FTC-Iowa/WiFiRemote-HW/prj/WifiRemote.pdf

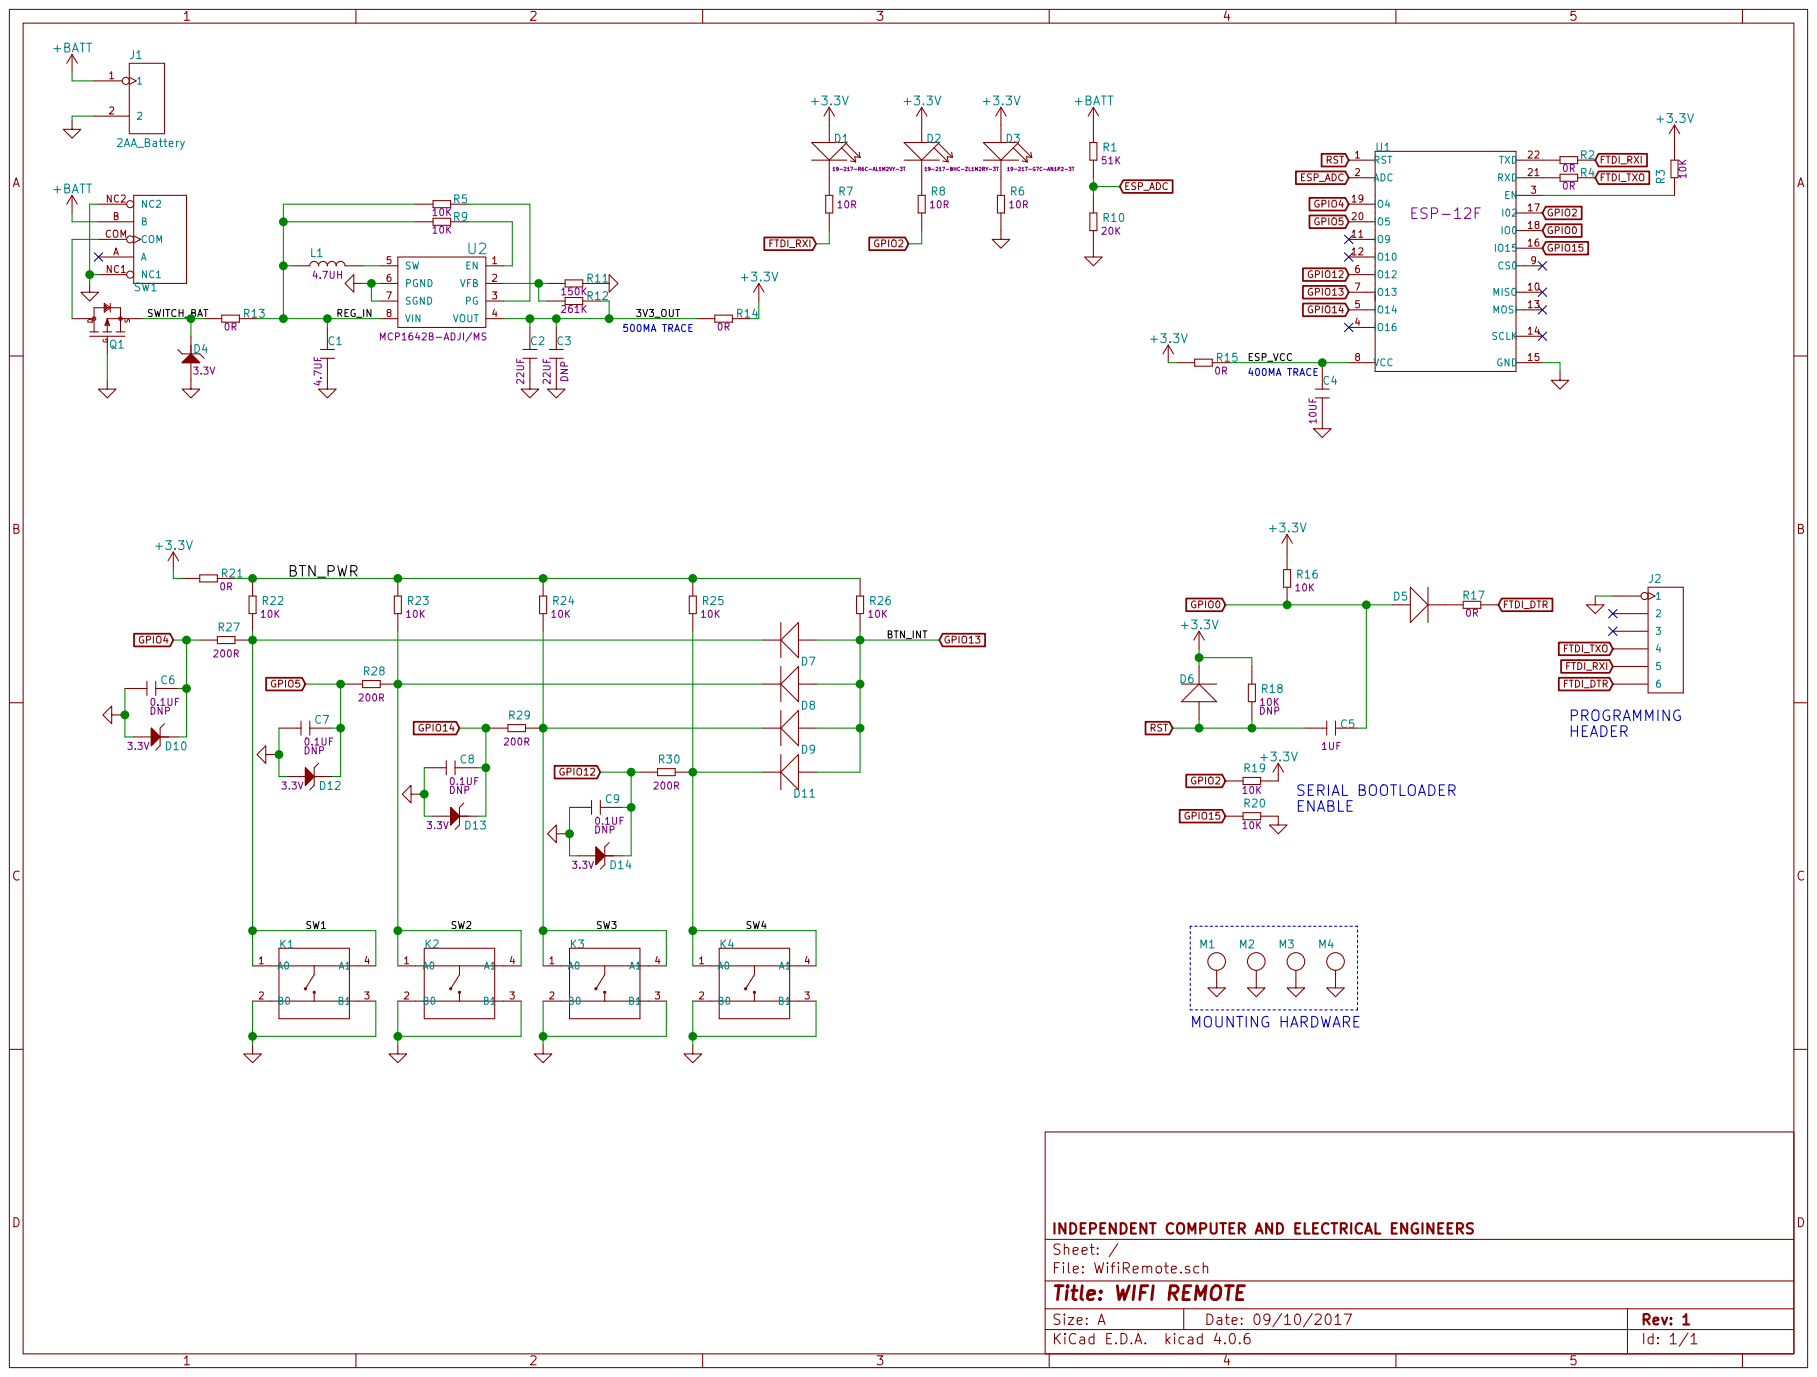
[picture p1: page 1]

B | NC1 NC1 NC2 NC2 COM COM

INDEPENDENT COMPUTER AND ELECTRICAL ENGINEERS
File: WifiRemote.sch Sheet: /
Id: 1/1 Title: WIFI REMOTE
