FTC-Iowa/WiFiRemote-HW/prj/WifiRemote.kicad_pcb

## KiCad design prj/WifiRemote.kicad_pcb (2017-12-10)

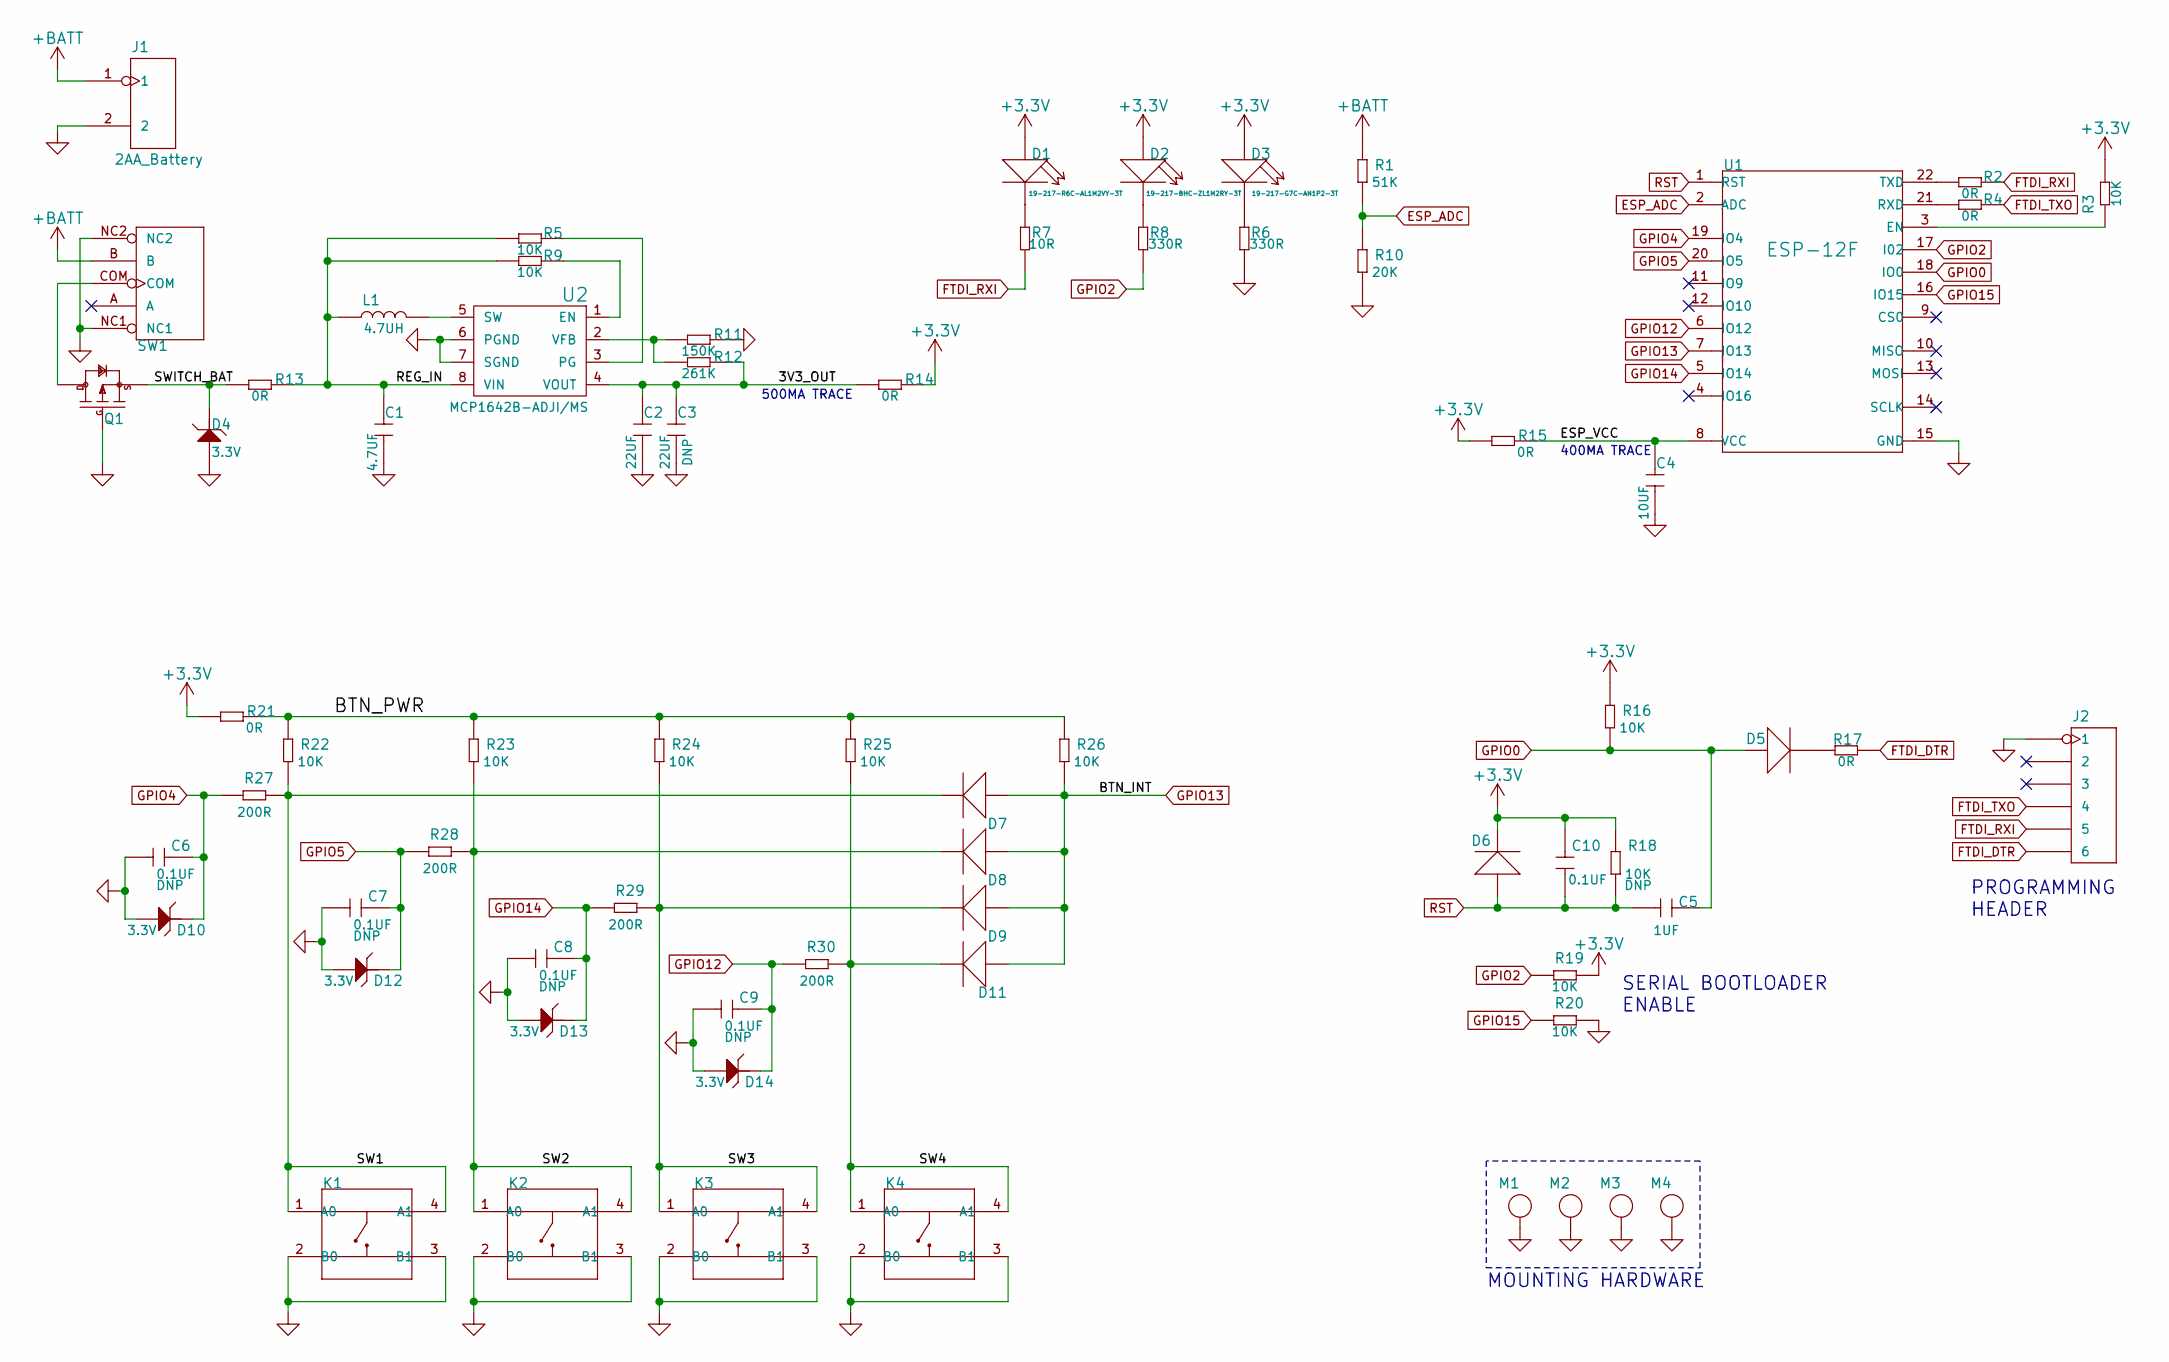
[picture p2: schematic WifiRemote.sch, WIFI REMOTE]

Parts:
C1: CERAMIC-4.7UF-10V-10%-X5R_0603_; C0603; MPN CC0603KRX5R6BB475
C2, C3: CERAMIC-22UF-6.3V-20%-X5R_0805_; C0805; MPN CC0805MKX5R5BB226
C4: CERAMIC-10UF-10V-10%-X5R_0603_; C0603; MPN CC0603KRX5R6BB106
C5: CERAMIC-1UF-25V-10%-X7R_0603_; C0603; MPN CC0603KRX7R8BB105
C6, C7, C8, C9, C10: CERAMIC-100NF-50V-10%-X7R_0603_; C0603; MPN CC0603KRX7R9BB104
D1: LED-SMD-RED-DIFFUSED_0603_; LED-0603; MPN 19-217-R6C-AL1M2VY-3T
D2: SMD-LED-CLEAR-BLUE_0603_; LED-0603; MPN 19-217-BHC-ZL1M2RY-3T
D3: SMD-LED-CLEAR-GREEN_0603_; LED-0603; MPN 19-217-G7C-AN1P2-3T
D4, D10, D12, D13, D14: SMD-Diode-TVS-3.3VMW-15V-SOD-523; SOD-523_IMPROVED; MPN CJ;CESD3V3D5
D5, D6, D7, D8, D9, D11: SMD-DIODE-SCHOTTKY-20V-1A_SOD-123_; SOD-123; MPN B5819W
J1: 2AA_Battery; header_1x2; MPN BH-321-1A
J2: DIP-BLACK-MALE-HEADER_6P-2.54_; H6-2.54; MPN P125-1106A1BS116A1
K1, K2, K3, K4: DIP-SWITCH-TACTILE-SPST-NO_TS-1109_4P-D6.0MM_; SW4-6.0X6.0X5.0MM
L1: SMD-Inductor-4.7uH-20%-L0420; ICEE_Inductor_SPD3D16-4R7M; MPN SPD3D16-4R7M
M1, M2, M3, M4: Mechanical_Mount; mounting_panhead6_5mm
Q1: SMD-MOSFET-P-CH-20V-2A-FDN340P_SOT-23_; SOT-23; MPN FDN340P
R1: SMD-RES-51K-5%-1_10W_0603_; R0603; MPN RC0603JR-0751KL
R2, R4, R13, R14, R15, R17, R21: SMD-RES-0R-5%-1_10W_0603_; R0603; MPN RC0603JR-070RL
R3, R16, R18, R19, R20, R22, R23, R24, R25, R26: SMD-RES-10K-5%-1_10W_0603_; R0603; MPN RC0603JR-0710KL
R5, R9: SMD-RES-10K-1%-1_10W_0603_; R0603; MPN RC0603FR-0710KL
R6, R8: SMD-RES-330R-1%-1_10W_0603_; R0603; MPN RC0603FR-07330RL
R7: SMD-RES-10R-5%-1_10W_0603_; R0603; MPN RC0603JR-0710RL
R10: SMD-RES-20K-1%-1_10W_0603_; R0603; MPN RC0603FR-0720KL
R11: SMD-RES-150K-1%-1_10W_0603_; R0603; MPN RC0603FR-07150KL
R12: SMD-RES-261K-1%-1_10W_0603_; R0603; MPN CRCW0603261KFKEA
R27, R28, R29, R30: SMD-RES-200R-5%-1_10W_0603_; R0603; MPN RC0603JR-07200RL
SW1: DIP-TOGGLE-SWITCH-ON-ON_3+2P-8.8X4.6MM_-90D; SW5-2.0-8.8X4.4X4.7MM-90D; MPN 3P-2.0-90D3P-2.0-90D-REINFORCE
U1: CONTROLLER-ESP8266; ESP-12F_SMT_22PIN; PART NUMBER ESP-12F
U2: BOOST-MCP1642B-ADJI/MC-MSOP8; MSOP-8_3x3mm_Pitch0.65mm; PART NUMBER MCP1642B-ADJI/MS

Connections:
+3V3: C10.1, D1.+, D2.+, D3.+, D6.-, R3.1, R14.1, R15.2, R16.1, R18.1, R19.2, R21.2
+BATT: J1.1, R1.1, SW1.B
/3V3_OUT: C2.1, C3.1, R12.1, R14.2, U2.4 (VOUT)
/BTN_PWR: R21.1, R22.1, R23.1, R24.1, R25.1, R26.1
/ESP_VCC: C4.1, R15.1, U1.8 (VCC)
/REG_IN: C1.1, L1.1, R5.2, R9.2, R13.1, U2.8 (VIN)
/SW1: D7.-, K1.1 (A0), K1.4 (A1), R22.2, R27.2
/SW2: D8.-, K2.1 (A0), K2.4 (A1), R23.2, R28.2
/SW3: D9.-, K3.1 (A0), K3.4 (A1), R24.2, R29.2
/SW4: D11.-, K4.1 (A0), K4.4 (A1), R25.2, R30.2
/SWITCH_BAT: D4.1, Q1.2 (S), R13.2
ESP_ADC: R1.2, R10.1, U1.2 (ADC)
FTDI_DTR: J2.6, R17.1
FTDI_RXI: J2.5, R2.1, R7.2
FTDI_TXO: J2.4, R4.1
GNDD: C1.2, C2.2, C3.2, C4.2, C6.1, C7.1, C8.1, C9.1, D4.2, D10.2, D12.2, D13.2, D14.2, J1.2, J2.1, K1.2 (B0), K1.3 (B1), K2.2 (B0), K2.3 (B1), K3.2 (B0), K3.3 (B1), K4.2 (B0), K4.3 (B1), M1.1, M2.1, M3.1, M4.1, Q1.1 (G), R6.2, R10.2, R11.1, R20.2, SW1.NC1, SW1.NC2, U1.15 (GND), U2.6 (PGND), U2.7 (SGND)
GPIO0: C5.2, D5.+, R16.2, U1.18 (IO0)
GPIO2: R8.2, R19.1, U1.17 (I02)
GPIO4: C6.2, D10.1, R27.1, U1.19 (IO4)
GPIO5: C7.2, D12.1, R28.1, U1.20 (IO5)
GPIO12: C9.2, D14.1, R30.1, U1.6 (IO12)
GPIO13: D7.+, D8.+, D9.+, D11.+, R26.2, U1.7 (IO13)
GPIO14: C8.2, D13.1, R29.1, U1.5 (IO14)
GPIO15: R20.1, U1.16 (IO15)
unnamed: D1.-, R7.1
unnamed: D2.-, R8.1
unnamed: D3.-, R6.1
unnamed: D5.-, R17.2
unnamed: L1.2, U2.5 (SW)
unnamed: Q1.3 (D), SW1.COM
unnamed: R2.2, U1.22 (TXD)
unnamed: R3.2, U1.3 (EN)
unnamed: R4.2, U1.21 (RXD)
unnamed: R5.1, U2.3 (PG)
unnamed: R9.1, U2.1 (EN)
unnamed: R11.2, R12.2, U2.2 (VFB)
RST: C5.1, C10.2, D6.+, R18.2, U1.1 (RST)

Notes on the sheet:
PROGRAMMING HEADER
SERIAL BOOTLOADER ENABLE
500MA TRACE
400MA TRACE
MOUNTING HARDWARE

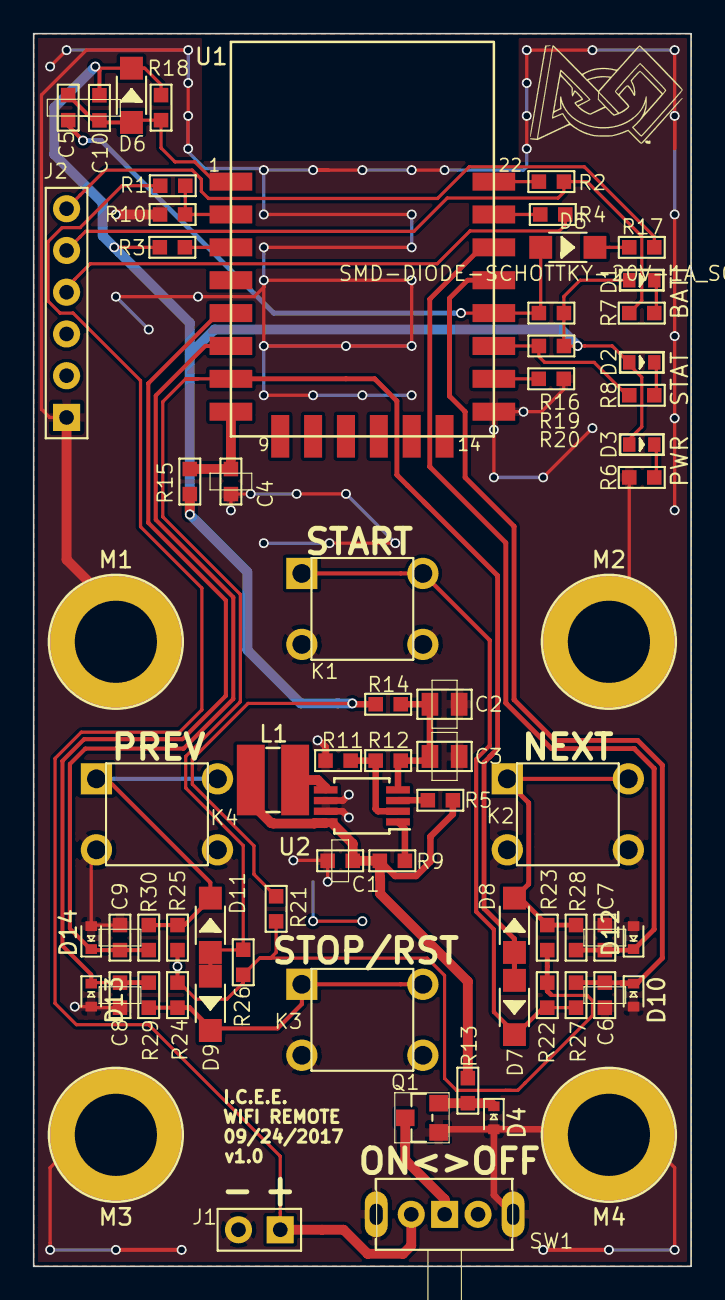
[picture p3: board WifiRemote.kicad_pcb from above]

Board: 2 copper layers, 40.0 x 75.0 mm, 69 parts (0 on the bottom side), 37 nets.
