FTC-Iowa/WiFiRemote-HW/(commit log)

2017-08-31 Added project files and folder structure
    [WifiRemote.kicad_pcb, WifiRemote.sch]
2017-09-02 Began initial schematic development
    [WifiRemote.sch]
2017-09-03 Completed power supply design
    [WifiRemote.kicad_pcb, WifiRemote.sch]
2017-09-03 Added ESP and FTDI interface in Schematic
    [WifiRemote.sch]
2017-09-05 Added push buttons, ESP programming lines, and battery voltage monitoring
    [WifiRemote.sch]
2017-09-05 Added power switch
    [WifiRemote.sch]
2017-09-09 Added library files for resistors, caps, inductors, and ESP8266
2017-09-09 Added resistors and boost regulator libraries
2017-09-09 Added libraries and several components to schematic
    [WifiRemote.sch]
2017-09-09 Added inductors library and wired boost regulator
    [WifiRemote.sch]
2017-09-09 Added 3.3V TVS diode
2017-09-09 Rev1 schematic all components placed and wired
    [WifiRemote.sch]
2017-09-10 Arranged designators, Added text descriptions, changed border template
    [WifiRemote.sch]
2017-09-10 Added IC and capacitor .dcm files
2017-09-10 Added footprints for all components, modified some sch libraries to add BOM info
    [WifiRemote.sch]
2017-09-11 Started layout
    [WifiRemote.kicad_pcb, WifiRemote.sch]
2017-09-12 Updated ADC input for 3V input (2x AA's)
    [WifiRemote.sch]
2017-09-13 Added battery monitoring LED, changed ADC resistor divider, and added ESD + reverse polarity protection on battery
    [WifiRemote.sch]
2017-09-15 Added button debounce, rev polarity prot, updated ESP-12F, added red LED, updated ADC resistor values
    [WifiRemote.sch]
2017-09-15 Updated footprints and removed ESP-12F incorrect footprint
    [WifiRemote.sch]
2017-09-15 Fixed regulator pinout, added mechanical mounts to schematic
    [WifiRemote.sch]
2017-09-15 Added mounting hole footprint
    [WifiRemote.sch]
2017-09-15 First rev of layout
    [WifiRemote.kicad_pcb]
2017-09-18 Hid all value descriptors in layout
    [WifiRemote.kicad_pcb]
2017-09-19 Finished component layout of regulator
    [WifiRemote.kicad_pcb]
2017-09-19 Swapped J1 header (Battery) and J2 header (Programming)
    [WifiRemote.kicad_pcb]
2017-09-19 Routing has begun
    [WifiRemote.kicad_pcb, WifiRemote.sch]
2017-09-20 Swapped LED colors, changed mechanical mounts, fixed schematic TVS diode pins, edited button connections to ESP
    [WifiRemote.kicad_pcb, WifiRemote.sch]
2017-09-21 Changed button GPIO association and updated mechanical mount pin
    [WifiRemote.sch]
2017-09-21 Updated TVS diode pinout
    [WifiRemote.sch]
2017-09-21 Added new SOD-523 diode footprint to ICEE library
    [WifiRemote.sch]
2017-09-21 Completed routing awaiting review
    [WifiRemote.kicad_pcb]
2017-09-21 Updated references
    [WifiRemote.kicad_pcb]
2017-09-21 Swapped D2 and D3
    [WifiRemote.kicad_pcb, WifiRemote.sch]
2017-09-24 Swapped D1 and D2 for layout
    [WifiRemote.sch]
2017-09-24 Updated battery connector
    [WifiRemote.sch]
2017-09-24 Added 2 pin header footprint
2017-09-24 Added footprint for header_1x2
    [WifiRemote.sch]
2017-09-24 changes stemming from layout review
    [WifiRemote.kicad_pcb]
2017-09-24 Swapped diode packages
    [WifiRemote.sch]
2017-09-24 Updates to diodes
    [WifiRemote.kicad_pcb, WifiRemote.sch]
2017-09-24 Changed LED packages to 0603
    [WifiRemote.sch]
2017-09-24 Changed LED annotations
    [WifiRemote.kicad_pcb, WifiRemote.sch]
2017-09-24 Updated gitignore to allow .csv files and added Rev1 BOM
    [WifiRemote_Rev1_BOM.csv]
2017-09-24 Added PLACE field column
    [WifiRemote.sch]
2017-09-24 Added descriptive BOM with associated costs
    [WifiRemote_Rev1_Descriptive_BOM.csv]
2017-09-24 Added silkscreen logos
    [WifiRemote.kicad_pcb]
2017-09-24 Added gerber files
    [WifiRemote-B.Cu.gbr, WifiRemote-B.Mask.gbr, WifiRemote-B.SilkS.gbr, WifiRemote-Edge.Cuts.gbr, WifiRemote-F.Cu.gbr, WifiRemote-F.Mask.gbr, WifiRemote-F.SilkS.gbr, WifiRemote.drl]
2017-09-25 Updated BOM
    [WifiRemote_Rev1_BOM.csv]
2017-09-25 Updated BOM to follow all Seeed reqs
    [WifiRemote_Rev1_BOM.csv]
2017-09-25 Updated gerber files for ordering
    [WifiRemote-B.Cu.gbr, WifiRemote-B.Mask.gbr, WifiRemote-B.SilkS.gbr, WifiRemote-Edge.Cuts.gbr, WifiRemote-F.Cu.gbr, WifiRemote-F.Mask.gbr, WifiRemote-F.SilkS.gbr, WifiRemote.drl]
2017-09-25 Added slotted holes to switch
    [WifiRemote.kicad_pcb]
2017-09-26 Removed non Seeed OPL parts from orderable BOM
    [WifiRemote_Rev1_BOM.csv]
2017-10-24 Updated Schematic PDF
2017-12-10 Changed R6 and R8 to 330R and added C10
    [WifiRemote.kicad_pcb, WifiRemote.sch]
2017-12-10 Updated silk screen issue and changed inductor footprint
    [WifiRemote.kicad_pcb, WifiRemote.sch]
2017-12-10 Replaced TVS Diode footprint to included polarity marker
    [WifiRemote.kicad_pcb, WifiRemote.sch]
